lucasY5732/ESP32-Ultrasonic-Distance-System/README.md

# ESP32-Ultrasonic-Distance-System
ESP32-based ultrasonic distance sensing system with NeoPixel LED, buzzer, and LCD multi-modal feedback.
